esasiela/hcgs-midi-mud/README.md

# hcgs-midi-mud

This is the firmware, schematics, and artwork files for an Arduino-based MIDI Step Sequencer.

Details about the behavior, design, software, and hardware are at [Hedge Court](https://www.hedgecourt.com/robots/grumpenspiel/midi-mud/).
