esasiela/hcgs-midi-mud/front-panel/hc-midi-mud-front.png

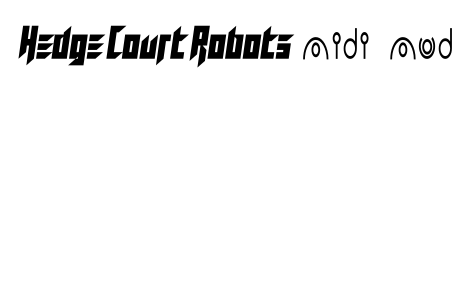
front-panel/hc-midi-mud-front.png
