esasiela/hcgs-midi-mud/front-panel/hc-midi-mud-front.dxf

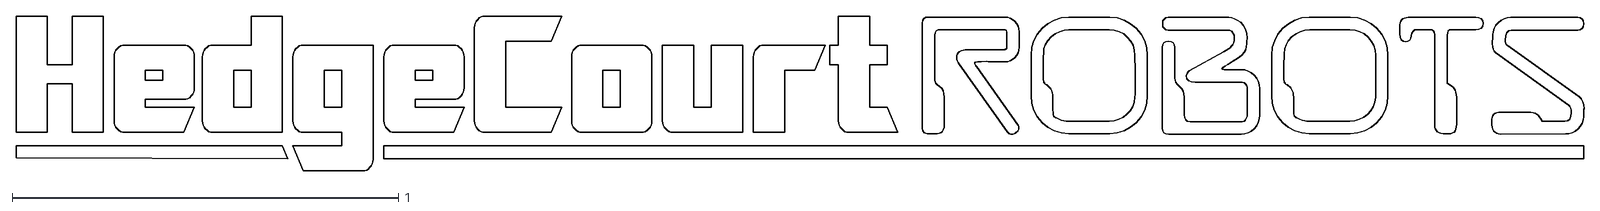
[picture p2: CAD file, 2018-12-17]
front-panel/hc-midi-mud-front.dxf
4.06 x 0.401
