esasiela/hcgs-midi-mud/eagle/hcgs-midi-mud-motherboard.brd

## EAGLE design eagle/hcgs-midi-mud-motherboard.brd (2018-12-17)

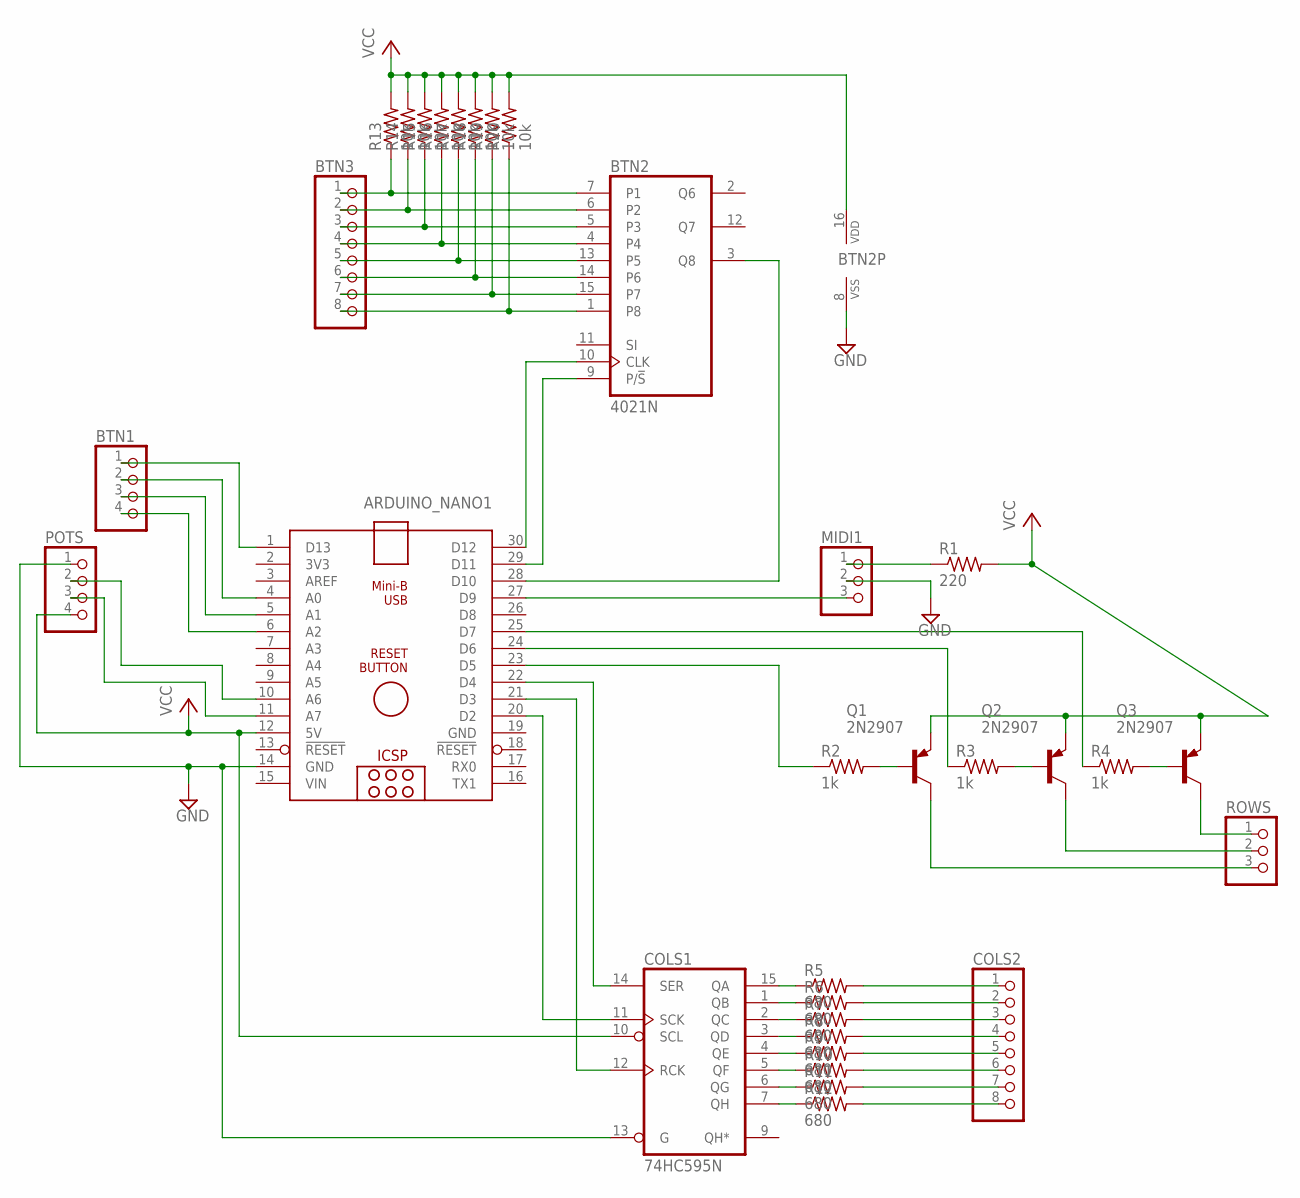
[picture p3: schematic hcgs-midi-mud-motherboard.sch]

Parts:
ARDUINO_NANO1: ARDUINO_NANO_HCARDUINO_NANO_NO_HOLE; ARDUINO_NANO_NO_HOLE
BTN1: PINHD-1X4; 1X04
BTN2: 4021N; DIL16
BTN3: PINHD-1X8; 1X08
COLS1: 74HC595N; DIL16
COLS2: PINHD-1X8; 1X08
MIDI1: PINHD-1X3; 1X03
POTS: PINHD-1X4; 1X04
Q1, Q2, Q3: 2N2907; TO92-EBC-OVAL
R1: 220; 0309/12
R2, R3, R4: 1k; 0309/12
R5, R6, R7, R8, R9, R10, R11, R12: 680; 0309/12
R13, R14, R15, R16, R17, R18, R19, R20: 10k; 0309/12
ROWS: PINHD-1X3; 1X03

Connections:
GND: ARDUINO_NANO1.14 (GND), ARDUINO_NANO1.19 (GND), BTN2.8 (VSS), COLS1.8 (GND), COLS1.13 (G), MIDI1.2, POTS.1
unnamed: ARDUINO_NANO1.1 (D13), BTN1.1
unnamed: ARDUINO_NANO1.4 (A0), BTN1.2
unnamed: ARDUINO_NANO1.11 (A7), POTS.3
unnamed: ARDUINO_NANO1.10 (A6), POTS.2
unnamed: ARDUINO_NANO1.5 (A1), BTN1.3
unnamed: ARDUINO_NANO1.6 (A2), BTN1.4
unnamed: Q1.B, R2.2
unnamed: MIDI1.1, R1.1
unnamed: Q2.B, R3.2
unnamed: ARDUINO_NANO1.27 (D9), MIDI1.3
unnamed: Q3.B, R4.2
unnamed: ARDUINO_NANO1.23 (D5), R2.1
unnamed: ARDUINO_NANO1.24 (D6), R3.1
unnamed: ARDUINO_NANO1.25 (D7), R4.1
unnamed: Q1.C, ROWS.3
unnamed: Q2.C, ROWS.2
unnamed: Q3.C, ROWS.1
unnamed: COLS1.15 (QA), R5.1
unnamed: COLS1.1 (QB), R6.1
unnamed: COLS1.2 (QC), R7.1
unnamed: COLS1.3 (QD), R8.1
unnamed: COLS1.4 (QE), R9.1
unnamed: COLS1.5 (QF), R10.1
unnamed: COLS1.6 (QG), R11.1
unnamed: COLS1.7 (QH), R12.1
unnamed: COLS2.1, R5.2
unnamed: COLS2.2, R6.2
unnamed: COLS2.3, R7.2
unnamed: COLS2.4, R8.2
unnamed: COLS2.5, R9.2
unnamed: COLS2.6, R10.2
unnamed: COLS2.7, R11.2
unnamed: COLS2.8, R12.2
unnamed: ARDUINO_NANO1.20 (D2), COLS1.11 (SCK)
unnamed: ARDUINO_NANO1.21 (D3), COLS1.12 (RCK)
unnamed: BTN2.1 (P8), BTN3.8, R20.1
unnamed: ARDUINO_NANO1.22 (D4), COLS1.14 (SER)
unnamed: BTN2.15 (P7), BTN3.7, R19.1
unnamed: BTN2.14 (P6), BTN3.6, R18.1
unnamed: BTN2.13 (P5), BTN3.5, R17.1
unnamed: BTN2.4, BTN3.4, R16.1
unnamed: BTN2.5 (P3), BTN3.3, R15.1
unnamed: BTN2.6 (P2), BTN3.2, R14.1
unnamed: BTN2.7 (P1), BTN3.1, R13.1
unnamed: ARDUINO_NANO1.30 (D12), BTN2.10 (CLK)
unnamed: ARDUINO_NANO1.28 (D10), BTN2.3 (Q8)
unnamed: ARDUINO_NANO1.29 (D11), BTN2.9 (P/!S)
VCC: ARDUINO_NANO1.12 (5V), BTN2.16 (VDD), COLS1.10 (SCL), COLS1.16 (VCC), POTS.4, Q1.E, Q2.E, Q3.E, R1.2, R13.2, R14.2, R15.2, R16.2, R17.2, R18.2, R19.2, R20.2
VIN: ARDUINO_NANO1.15 (VIN)

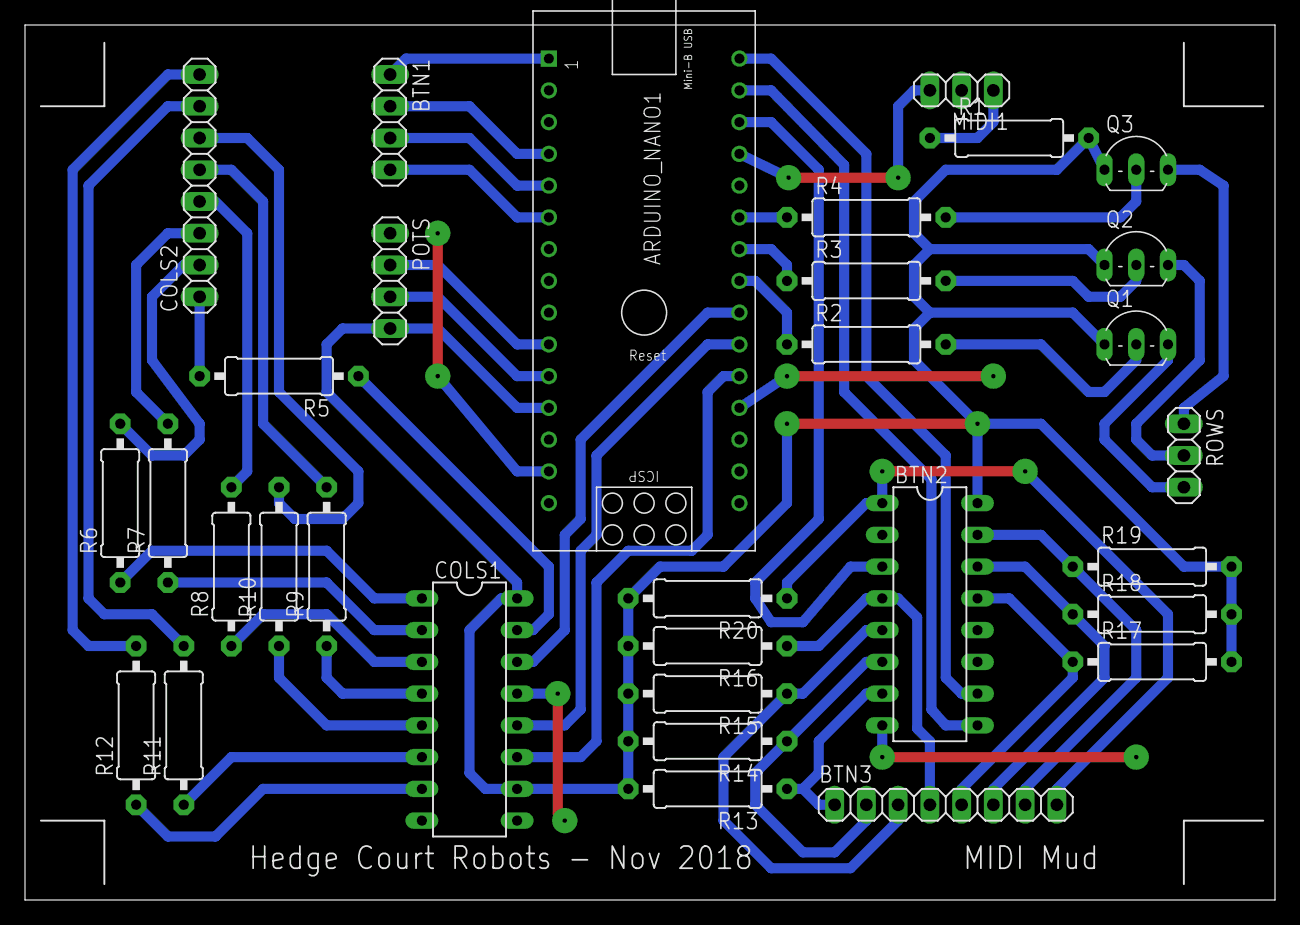
[picture p4: board hcgs-midi-mud-motherboard.brd from above]

Board: 2 copper layers, 100.0 x 70.0 mm, 32 parts (0 on the bottom side), 49 nets.
