esasiela/hcgs-midi-mud/eagle/hcgs-midi-mud-led.brd

## EAGLE design eagle/hcgs-midi-mud-led.brd (2018-12-17)

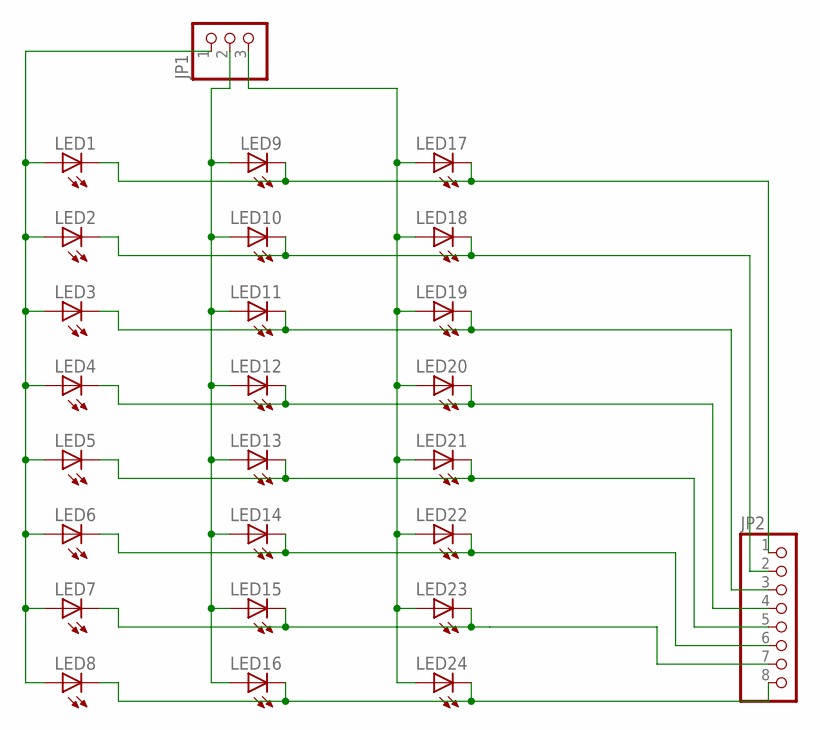
[picture p5: schematic hcgs-midi-mud-led.sch]

Parts:
JP1: PINHD-1X3; 1X03
JP2: PINHD-1X8; 1X08
LED1, LED2, LED3, LED4, LED5, LED6, LED7, LED8, LED9, LED10, LED11, LED12, LED13, LED14, LED15, LED16, LED17, LED18, LED19, LED20, LED21, LED22, LED23, LED24: LED5MM

Connections:
unnamed: JP1.1, LED1.A, LED2.A, LED3.A, LED4.A, LED5.A, LED6.A, LED7.A, LED8.A
unnamed: JP1.2, LED9.A, LED10.A, LED11.A, LED12.A, LED13.A, LED14.A, LED15.A, LED16.A
unnamed: JP1.3, LED17.A, LED18.A, LED19.A, LED20.A, LED21.A, LED22.A, LED23.A, LED24.A
unnamed: JP2.1, LED1.K (C), LED9.K (C), LED17.K (C)
unnamed: JP2.2, LED2.K (C), LED10.K (C), LED18.K (C)
unnamed: JP2.3, LED3.K (C), LED11.K (C), LED19.K (C)
unnamed: JP2.4, LED4.K (C), LED12.K (C), LED20.K (C)
unnamed: JP2.5, LED5.K (C), LED13.K (C), LED21.K (C)
unnamed: JP2.6, LED6.K (C), LED14.K (C), LED22.K (C)
unnamed: JP2.7, LED7.K (C), LED15.K (C), LED23.K (C)
unnamed: JP2.8, LED8.K (C), LED16.K (C), LED24.K (C)

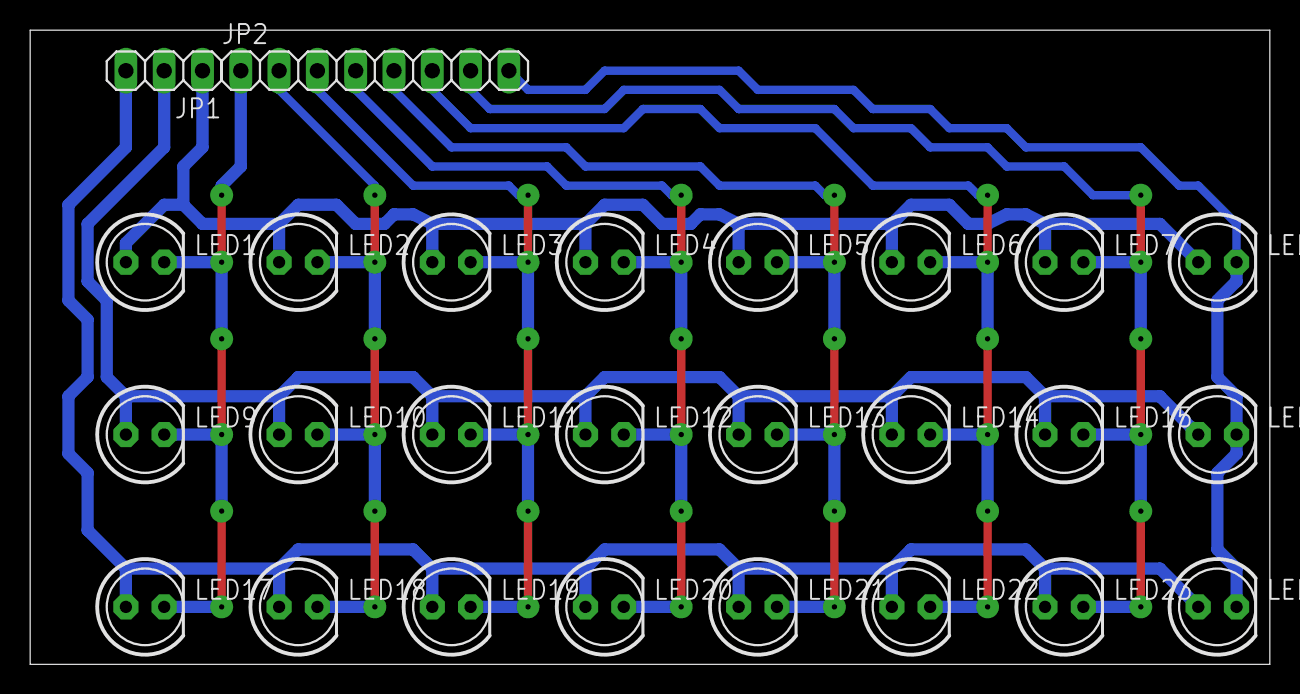
[picture p6: board hcgs-midi-mud-led.brd from above]

Board: 2 copper layers, 82.2 x 42.1 mm, 26 parts (0 on the bottom side), 11 nets.
